hskuan/tft35-deck/BTT_TFT_Touch/src/peripheral_pins_btt.c

// UART pin maps for the BTT TFT35 V3.0, overriding the (weak) NUCLEO_F207ZG
// variant tables. The Nucleo board reserves PA2/PA9/PB10 for Ethernet, USB
// and ST-Link, so they are commented out there, which makes USART1-3 unusable
// on the TFT35's headers.
#include "Arduino.h"
#include "PeripheralPins.h"

#ifdef HAL_UART_MODULE_ENABLED
const PinMap PinMap_UART_TX[] = {
  {PA_2,  USART2, STM_PIN_DATA(STM_MODE_AF_PP, GPIO_PULLUP, GPIO_AF7_USART2)},  // 5-pin "RS232" header
  {PA_9,  USART1, STM_PIN_DATA(STM_MODE_AF_PP, GPIO_PULLUP, GPIO_AF7_USART1)},  // WiFi header
  {PB_10, USART3, STM_PIN_DATA(STM_MODE_AF_PP, GPIO_PULLUP, GPIO_AF7_USART3)},
  {PA_0,  UART4,  STM_PIN_DATA(STM_MODE_AF_PP, GPIO_PULLUP, GPIO_AF8_UART4)},
  {NC,    NP,     0}
};

const PinMap PinMap_UART_RX[] = {
  {PA_3,  USART2, STM_PIN_DATA(STM_MODE_AF_PP, GPIO_PULLUP, GPIO_AF7_USART2)},
  {PA_10, USART1, STM_PIN_DATA(STM_MODE_AF_PP, GPIO_PULLUP, GPIO_AF7_USART1)},
  {PB_11, USART3, STM_PIN_DATA(STM_MODE_AF_PP, GPIO_PULLUP, GPIO_AF7_USART3)},
  {PA_1,  UART4,  STM_PIN_DATA(STM_MODE_AF_PP, GPIO_PULLUP, GPIO_AF8_UART4)},
  {NC,    NP,     0}
};
#endif
