hskuan/tft35-deck/(commit log)

2026-11-08 Add README with setup guide and MIT license; fix bridge wiring docs
2026-11-09 ESP32-S3 bridge: TFT link on TX/RX pins, button-free uploads
    - Move the TFT UART to the pins labelled TX/RX (GPIO43/44); debug log to GPIO4/5.
    - Platform espressif32 6.9.0 (arduino-esp32 2.0.17): 2.0.6 did not re-enable
    the D+ pull-up when switching to the USB serial/JTAG port, so the board
    vanished from USB after the 1200-baud reset.
    - use_1200bps_touch + wait_for_upload_port: download mode is a different COM port.
    - Post-upload script clears the RTC force-download flag that esptool 4.5.1
    leaves set, so the new firmware starts without a replug.
    - Docs: wiring tables, flashing steps, status.
    [config.h, esp32s3_exit_download.py]
2026-11-09 OpenDeck plugin: fixed device id td-tft35deck
    The bridge's serial number on Windows is a per-USB-port instance id, so
    profiles disappeared when the bridge changed port or was swapped (Pico to
    ESP32-S3). config.json "deviceId" overrides the fixed id.
2026-11-09 Docs: ESP32-S3 SuperMini bridge verified with the TFT and OpenDeck
